d45459977-debug/SCADA/sensor_level/hcsr04_kalibrasi_volume/WhatsApp Image 2026-05-06 at 22.41.46 (1).jpeg

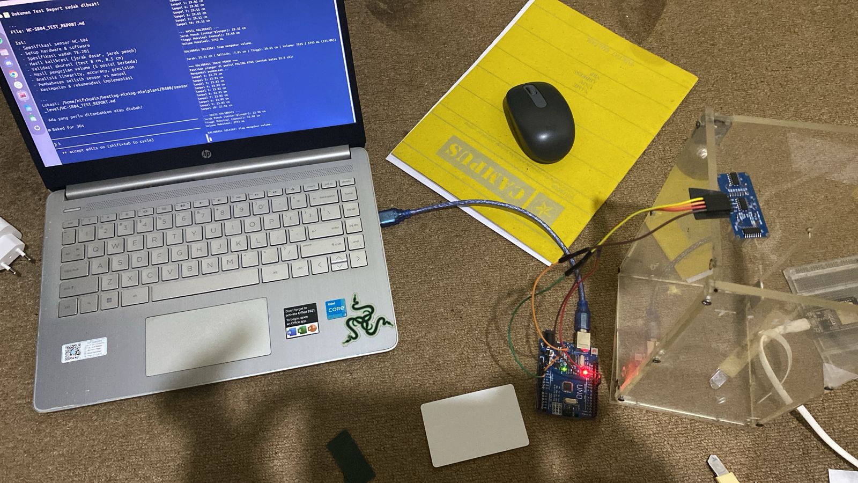
sensor_level/hcsr04_kalibrasi_volume/WhatsApp Image 2026-05-06 at 22.41.46 (1).jpeg
