d45459977-debug/SCADA/sensor_temp/sensor_flow/WhatsApp Image 2026-05-03 at 22.05.45.jpeg

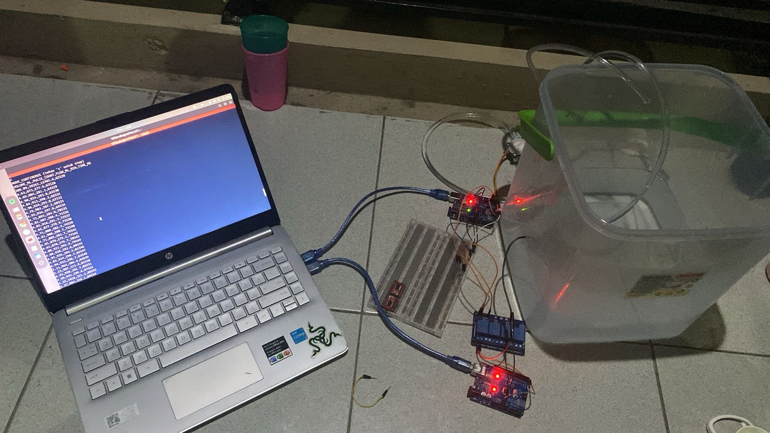
sensor_temp/sensor_flow/WhatsApp Image 2026-05-03 at 22.05.45.jpeg
