d45459977-debug/SCADA/sensor_flow/sensor_flow/Screenshot from 2026-05-03 22-05-53.png

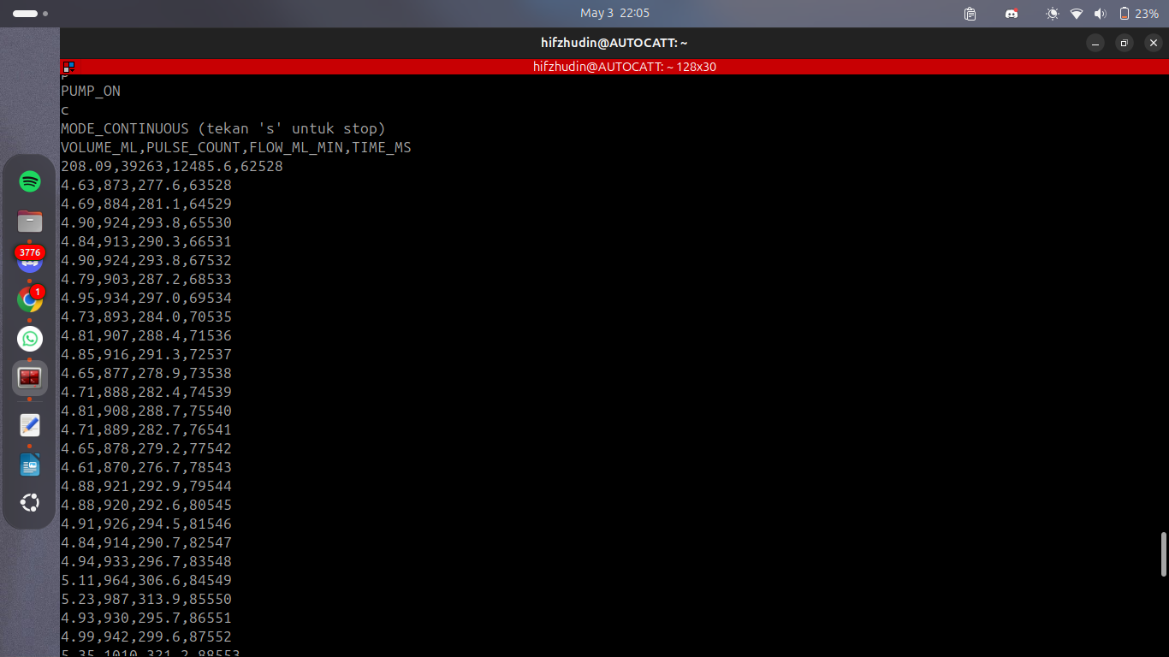
sensor_flow/sensor_flow/Screenshot from 2026-05-03 22-05-53.png
