d45459977-debug/SCADA/sensor_temp/sensor_level/Pasted image.png

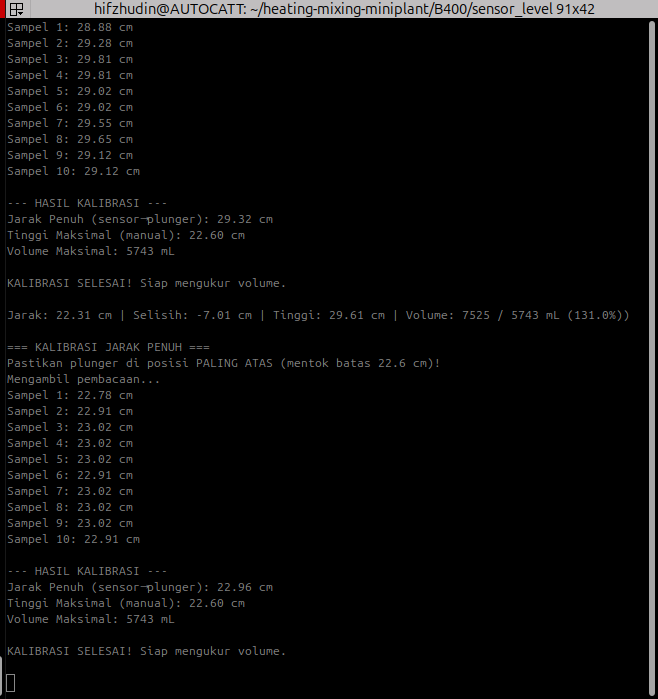
sensor_temp/sensor_level/Pasted image.png
