d45459977-debug/SCADA/sensor_temp/sensor_temp/DS18B20.png

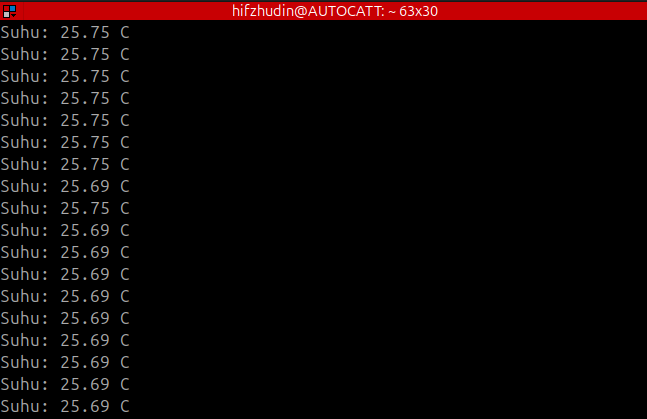
sensor_temp/sensor_temp/DS18B20.png
