d45459977-debug/SCADA/sensor_temp/sensor_temp/RANGKAIAN_DS18B20.jpeg

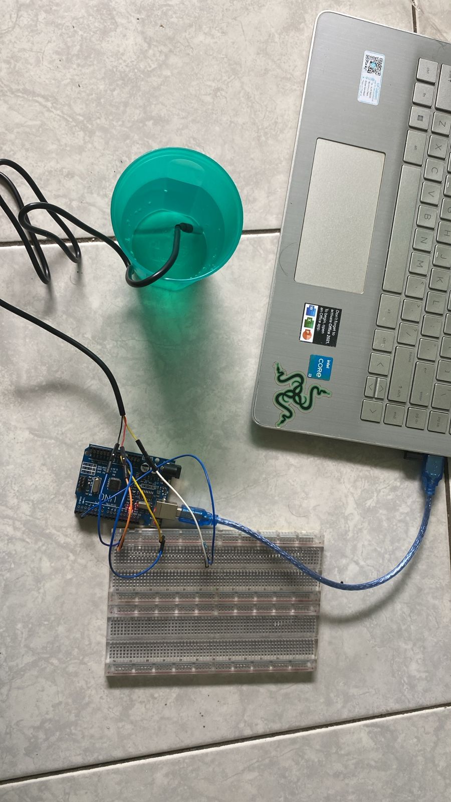
sensor_temp/sensor_temp/RANGKAIAN_DS18B20.jpeg
