d45459977-debug/SCADA/sensor_temp/DS18B20_TEST_REPORT.md

# DS18B20 Waterproof Temperature Sensor - Test Report

**Nomor Dokumen:** B400-SENS-001
**Tanggal:** 2026-04-29
**Sensor:** DS18B20 Waterproof Probe (Stainless Steel 6x50mm)
**Firmware:** Arduino Uno + OneWire + DallasTemperature

---

## 1. Spesifikasi Sensor

| Parameter | Nilai |
|---|---|
| Tipe | DS18B20 (TO-92 dalam stainless sheath) |
| Range Operasi | -55°C s/d +125°C |
| Akurasi | ±0.5°C @ -10°C s/d +85°C |
| Resolusi | 9-12 bit (programmable) |
| Supply Voltage | 3.0V - 5.5V |
| Kabel | 1 meter, 3 wire |
| Warna Kabel | Red=VCC, Blue=DATA, Black=GND |
| Waterproof | Ya (stainless steel sheath) |
| Dimensi Probe | 6mm diameter, 50mm panjang |

---

## 2. Setup Testing

### 2.1 Hardware

- **MCU:** Arduino Uno (ATmega328P)
- **Library:** OneWire v2.3.8, DallasTemperature v4.0.6
- **Pull-up Resistor:** 1kΩ (antara DATA dan VCC)
- **Pin Assignment:** D2 = DATA

### 2.2 Wiring Diagram

```
Arduino Uno               DS18B20 Sensor
─────────────────────────────────────────────

5V  ───┬───────────────────→ Red (VCC)
      │
      │
     1kΩ  ← Pull-up resistor
      │
      │
D2  ───┴───────────────────→ Blue (DATA)

GND ───────────────────────→ Black (GND)
```

### 2.3 Software

```cpp
#include <OneWire.h>
#include <DallasTemperature.h>

#define ONE_WIRE_BUS 2

OneWire oneWire(ONE_WIRE_BUS);
DallasTemperature sensors(&oneWire);

void setup() {
  Serial.begin(9600);
  sensors.begin();
}

void loop() {
  sensors.requestTemperatures();
  float tempC = sensors.getTempCByIndex(0);
  Serial.print("Suhu: ");
  Serial.print(tempC);
  Serial.println(" C");
  delay(1000);
}
```

---

## 3. Hasil Testing

### 3.1 Test Suhu Ruang (Baseline)

| Kondisi | Bacaan Sensor | Referensi | Error |
|---|---|---|---|
| Suhu ruang | 26.94°C | ~27°C | < 0.5°C |
| Stabil (10 menit) | 26.25 - 26.94°C | - | ±0.35°C |

**Status:** ✅ **PASS** — Bacaan stabil, masuk akurat

---

### 3.2 Test Pendinginan (Air + Es)

| Waktu | Bacaan | Kondisi |
|---|---|---|
| Awal | 26.94°C | Air ruang |
| + Es | 26 → 22°C | Es ditambahkan |
| Stabil | 22°C | Es mulai melebar |
| Pendinginan | 22 → 17°C | Thermal equilibrium |
| Akhir | 17°C | Stabil |

**Observasi:**
- Respon sensor **linear dan halus**
- Tidak ada jump/fluktuasi abnormal setelah wiring diperbaiki
- Thermal mass probe stainless memperlambat respon (wajar)

**Status:** ✅ **PASS** — Tren pendinginan sesuai ekspektasi

---

### 3.3 Issue yang Ditemukan

| Issue | Penyebab | Solusi | Status |
|---|---|---|---|
| Bacaan jump (22→24→28°C) | Wiring longgar di breadboard | Perbaiki koneksi kabel | ✅ Resolved |

---

## 4. Analisis

### 4.1 Akurasi

- Sensor tidak perlu **kalibrasi** karena:
  - Akurasi pabrik ±0.5°C sudah memenuhi requirement
  - Deadband controller ±1°C lebih lebar dari akurasi sensor
  - Tidak ada reference standard yang lebih akurat tersedia

### 4.2 Resistor Pull-up

- **Nilai yang dipakai:** 1kΩ (bukan 4.7kΩ standar)
- **Hasil:** Berfungsi normal untuk jarak kabel 1m
- **Catatan:** Untuk kabel > 5m, ganti ke 2.2kΩ atau 4.7kΩ

### 4.3 Warna Kabel

- **Non-standard:** Red=VCC, Blue=DATA, Black=GND
- **Perhatian:** Beda dengan standar (biasanya Yellow/White=DATA)
- **Rekomendasi:** Label/ dokumentasikan dengan jelas

### 4.4 Respon Termal

- Probe stainless 50mm memiliki **thermal mass** yang signifikan
- Respon tidak instan tapi stabil (tidak oscillasi)
- Cocok untuk aplikasi **temperature control** karena filtering natural

---

## 5. Kesimpulan

| Item | Verdict |
|---|---|
| Fungsi sensor | ✅ NORMAL |
| Akurasi | ✅ MEMENUHI (±0.5°C) |
| Stability | ✅ STABIL |
| Wiring (1k pull-up) | ✅ WORK (1m cable) |
| Waterproof | ✅ TAHAN CELUP |
| Ready untuk Slave 3 | ✅ YES |

---

## 6. Rekomendasi

1. **Tidak perlu kalibrasi tambahan** — pakai nilai pabrik
2. **Gunakan resistor 1kΩ** untuk kabel 1m
3. **Label kabel dengan jelas** — VCC/RED, DATA/BLUE, GND/BLACK
4. **Mounting:** Celupkan probe ke tangki dengan posisi tetap
5. **Future:** Untuk kabel > 5m, siapkan resistor 2.2kΩ atau 4.7kΩ

---

## 7. Lampiran

- Test code: `ds18b20_test.ino`
- Library: OneWire v2.3.8, DallasTemperature v4.0.6
- Foto setup: *(belum ada)*
- Datasheet: Maxim Integrated DS18B20

---

**Dibuat oleh:** Claude (Auto-generated)
**Disetujui:** *(pending user verification)*
