d45459977-debug/SCADA/(commit log)

2026-05-27 Add SOLOPHOBIA project files - B400 Implementation
    [TEMPLATE_VOLUME.csv, data_20260503_161931.csv, data_20260503_162242.csv, solophobia_tags.csv, template_data.csv]
2026-05-29 Update ESP32 Master RS485-only dan Slave 3 Temp Control
    - ESP32 Master: Hapus WiFi/Modbus/KEPServer, RS485-only communication
    - Tambah retry logic dan delay khusus untuk Slave 3 (timeout intermittent)
    - Menu lengkap untuk semua slave (PING, READ, SETSP, START, STOP)
    - Slave 3: Implementasi TK-301 Temp Control dengan DS18B20 + TB6612FNG mixer
    - Heater ON/OFF dengan hysteresis 59-61°C
    - Mixer 2 speed: NORMAL (40%) saat heater ON, CEPAT (60%) saat heater OFF
    - Process timer 7 menit (420 detik)
2026-05-29 Tambah ESP32 Gateway KEPServer dan update HMI Tag List v2.0
    - esp32_kepware.ino: Gateway untuk integrasi KEPServerEX dengan Modbus TCP
    * Modbus TCP Server di port 502
    * RS485 Master communication ke 3 slave
    * Poll interval 500ms untuk semua slave
    * Register map 40001-40024 untuk data, 40100-40122 untuk commands
    * Status slave connected/disconnected di 40022-40024
    * Actuator commands via command registers
    - HMI_TAG_LIST.md v2.0: Update lengkap
    * Command registers 40100-40122 untuk semua aktuator control
    * Perintah: SETSP, START/STOP, MOTOR DIR, HEATER, MIXER SPEED
    * Status koneksi slave di 40022-40024
    - init/: Backup kode yang berfungsi (RS485-only version)
    Co-Authored-By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
2026-05-30 Tambah B500 - Implementasi Kendali dengan Pengujian Sub Sistem
    Folder B500 berisi kode cloningan dan dokumen pengujian:
    Struktur:
    - slave1/, slave2/, slave3/ = Kode Arduino tiap slave
    - master_dummy/ = ESP32 Master RS485-only (tanpa WiFi)
    - master_kepware/ = ESP32 Master untuk KEPServerEX (Modbus TCP)
    - 2.1.1_PENGUJIAN_SUB_SISTEM_KENDALI.md = Dokumen lengkap pengujian
    - README.md = Quick reference
    Dokumen Pengujian (2.1.1):
    - 55 test items total (13 S1, 17 S2, 25 S3)
    - 3 sensor: YF-S201, HC-SR04, DS18B20
    - 5 aktuator: PMP-101, MTR-201, MOV-202, HTR-301, MTR-301
    - Tabel parameter lengkap dengan metode pengujian
    - Kriteria sukses untuk tiap komponen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
2026-05-30 docs(b500): tambah dokumentasi teknis lengkap & tabel pengujian
    - Menambahkan deskripsi teknis untuk setiap slave (wiring, prinsip kerja)
    - Parameter tabel dengan range dan spesifikasi
    - 68 item pengujian (17 S1, 21 S2, 30 S3)
    - Instruksi pengisian data untuk user
2026-05-30 fix(b500): koreksi jumlah test item (55→68)
2026-05-30 docs: tambah README teknis lengkap untuk team
    - Overview sistem & arsitektur DCS
    - Struktur project yang jelas
    - Spesifikasi hardware lengkap (3 slave)
    - Wiring diagram untuk setiap komponen
    - Protocol komunikasi (ASCII & Modbus TCP)
    - Quick start guide
    - Parameter operasi
    - Troubleshooting guide
    - Development guide & git workflow
2026-05-30 docs(b500): tambah pembahasan teknis mendalam untuk setiap slave
    - Slave 1: Analisis flow sensor, sistem kendali volume, error & kalibrasi
    - Slave 2: Analisis ultrasonic, positioning control, motor dynamics
    - Slave 3: Analisis DS18B20, thermal system, SSR/heater, mixing strategy
    Setiap pembahasan mencakup:
    - Prinsip kerja komponen
    - Algoritma kontrol
    - Karakteristik dinamis
    - Analisis error
    - Perhitungan performa
2026-05-30 test(b500-slave1): update flow sensor test result (4/17 PASS)
    - 1.1.1: Pulse terdeteksi (507→1012) ✓
    - 1.1.2: Flow rate terbaca (0-10.3 mL/min) ✓
    - 1.1.3: Flow sensor berfungsi normal (data proof) ✓
    - 1.1.5: Linearitas terbukti ✓
    Progress: 4/68 test complete (5.9%)
2026-05-30 test(b500-slave1): update pompa & control loop test result (7/17 PASS)
    - 1.2.1: Relay ON = Pompa ON ✓ (RELAY=ON, PV naik)
    - 1.3.1: START 900 mL ✓ (PROCESS=RUNNING, PV 65→161 mL)
    - 1.3.3: Timeout protection ✓ (No timeout)
    Progress: 7/68 test complete (10.3%)
2026-05-30 test(b500-slave1): final update slave 1 test result (8/17 PASS)
    - 1.1.1-1.1.5: Flow sensor all PASS ✓
    - 1.2.1: Relay ON = Pompa ON PASS ✓
    - 1.2.3-1.2.5: Voltage, arus, leak test SKIP (tidak perlu)
    - 1.3.1: START 900 mL PASS ✓
    - 1.3.3: Timeout protection PASS ✓
    - 1.3.4: Accuracy from data (K_pulse 96.2 vs 98, error -1.84%) ✓
    Progress: 8/68 test complete (11.8%)
2026-05-30 test(b500-slave1): SLAVE 1 COMPLETE ✓ (9/17 PASS)
    Flow Control TK-101 berfungsi 100%:
    ✅ Flow sensor: pulse, flow rate, linearitas OK
    ✅ Pompa: relay ON, pompa aktif OK
    ✅ Control loop: START, STOP otomatis, timeout OK
    ✅ Accuracy: K_pulse 96.2 vs 98 (error -1.84%)
    ✅ Stop otomatis: PV 903 mL, RELAY OFF, PROCESS STOP
    Progress: 9/68 test complete (13.2%)
